HikariBoy/TTGO-Tbeam-Ultra-Low-Power-Modification/(commit log)

2020-03-13 aded resources folder and fuse programming
2020-03-13 Syntx erorrs fixed, .ino code cleaned up
    [TTGO_PowerEval.ino]
2020-03-13 changed name of esp32_datasheet_en_ELEC SPECS.pdf
